organom/3dPrinterV1/Firmware/Marlin + Hysteresis/README.md

# Marlin 3D Printer Firmware


  * [Configuration & Compilation](/Documentation/Compilation.md)
  * Supported
    * [Features](/Documentation/Features.md)
    * [Hardware](/Documentation/Hardware.md)
    * [GCodes](/Documentation/GCodes.md)
  * Notes
    * [Auto Bed Leveling](/Documentation/BedLeveling.md)
    * [Filament Sensor](/Documentation/FilamentSensor.md)
    * [Ramps Servo Power](/Documentation/RampsServoPower.md)

##### [RepRap.org Wiki Page](http://reprap.org/wiki/Marlin)

## Quick Information

This is a firmware for reprap single-processor electronics setups.
It also works on the Ultimaker PCB. It supports printing from SD card+Folders, and look-ahead trajectory planning.
This firmware is a mashup between [Sprinter](https://github.com/kliment/Sprinter), [grbl](https://github.com/simen/grbl) and many original parts.

## Current Status: Bug Fixing

The Marlin development is currently revived. There's a long list of reported issues and pull requests, which we are working on currently.
We are actively looking for testers. So please try the current development version and report new issues and feedback.




What bugs are we working on: [Bug Fixing Round 3](https://github.com/MarlinFirmware/Marlin/milestones/Bug%20Fixing%20Round%203)

## Contact

__IRC:__ #marlin-firmware @freenode ([WebChat Client](https://webchat.freenode.net/?channels=marlin-firmware)

__Mailing List:__ marlin@lists.0l.de ([Subscribe](http://lists.0l.de/mailman/listinfo/marlin), [Archive](http://lists.0l.de/pipermail/marlin/))

## Credits

The current Marlin dev team consists of:

 - Erik van der Zalm ([@ErikZalm](https://github.com/ErikZalm))
 - [@daid](https://github.com/daid)

Sprinters lead developers are Kliment and caru.
Grbls lead developer is Simen Svale Skogsrud.
Sonney Jeon (Chamnit) improved some parts of grbl
A fork by bkubicek for the Ultimaker was merged.

More features have been added by:
  - Lampmaker,
  - Bradley Feldman,
  - and others...

## License

Marlin is published under the [GPL license](/Documentation/COPYING.md) because I believe in open development.
Please do not use this code in products (3D printers, CNC etc) that are closed source or are crippled by a patent.
