organom/3dPrinterV1/Photos/IMG_20151007_074051.jpg

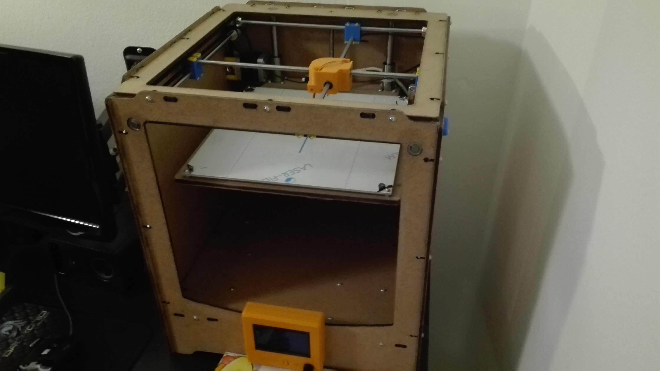
Photos/IMG_20151007_074051.jpg
