organom/3dPrinterV1/Photos/IMG_20160206_153725.jpg

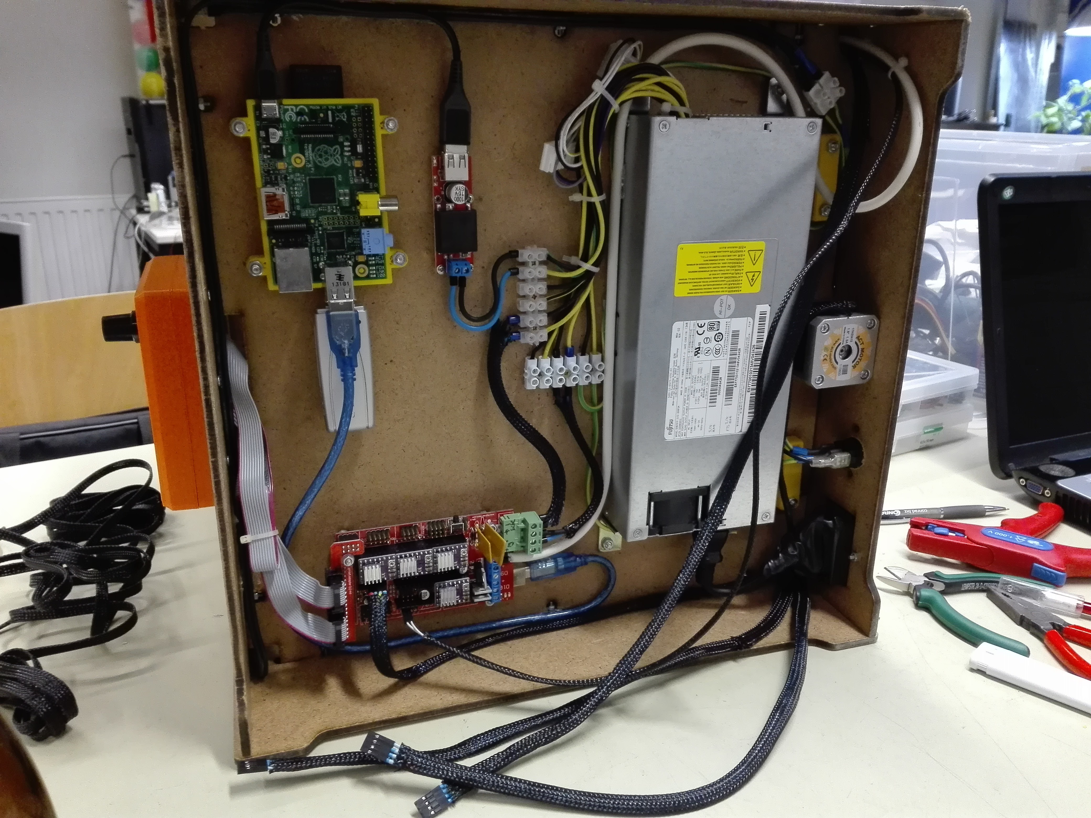
Photos/IMG_20160206_153725.jpg
