organom/3dPrinterV1/Photos/IMG_20160212_201310.jpg

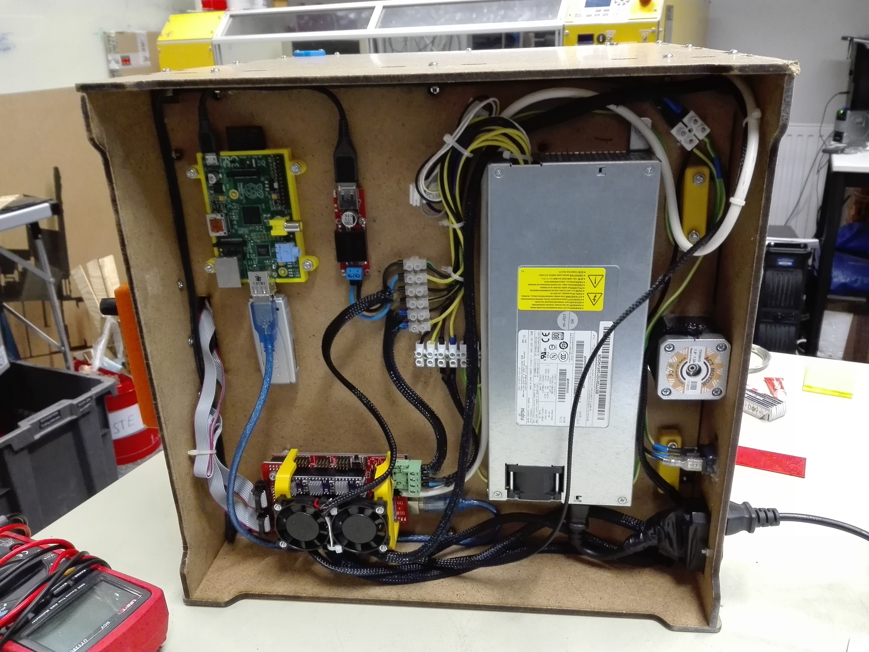
Photos/IMG_20160212_201310.jpg
