organom/3dPrinterV1/Photos/IMG_20160220_092918.jpg

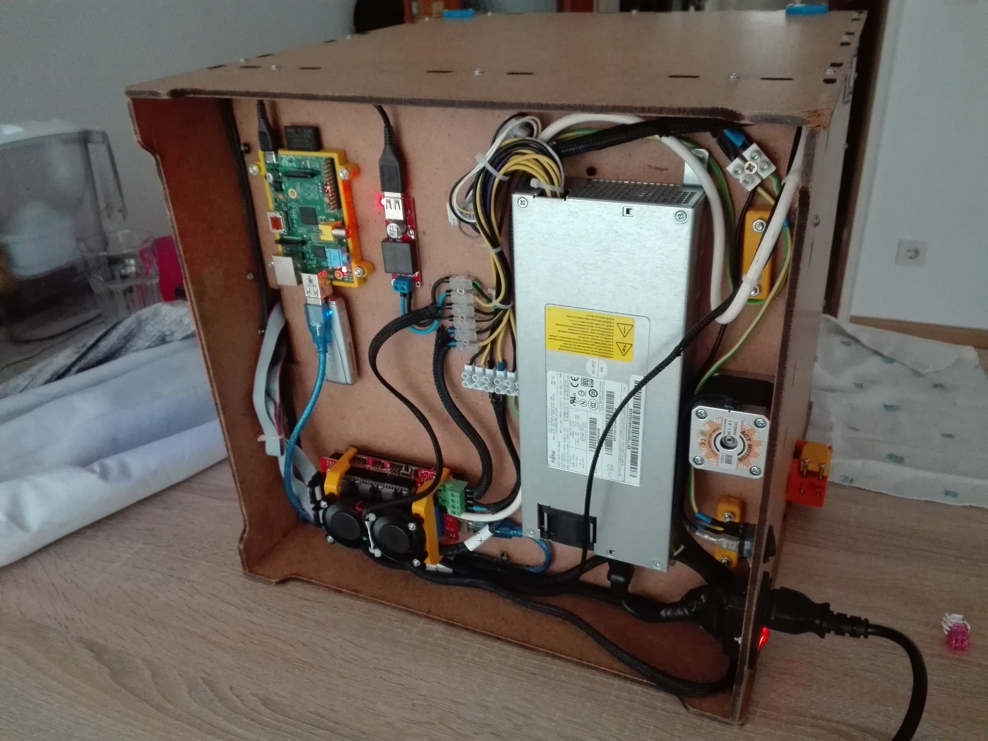
Photos/IMG_20160220_092918.jpg
