organom/3dPrinterV1/Photos/IMG_20170121_103842.jpg

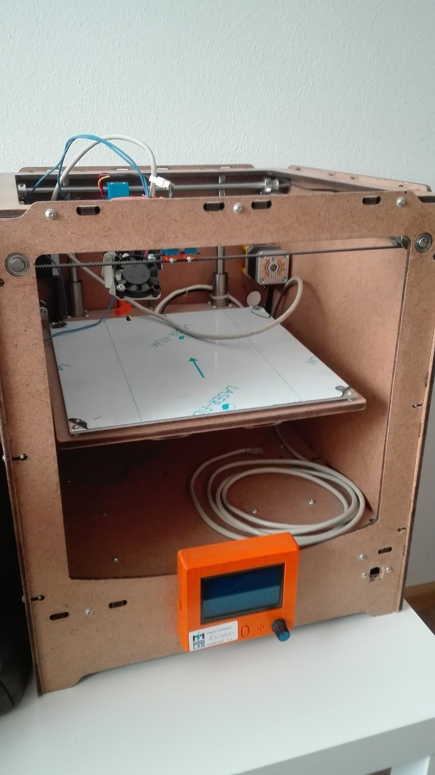
Photos/IMG_20170121_103842.jpg
