organom/3dPrinterV1/Photos/IMG_20170121_103855.jpg

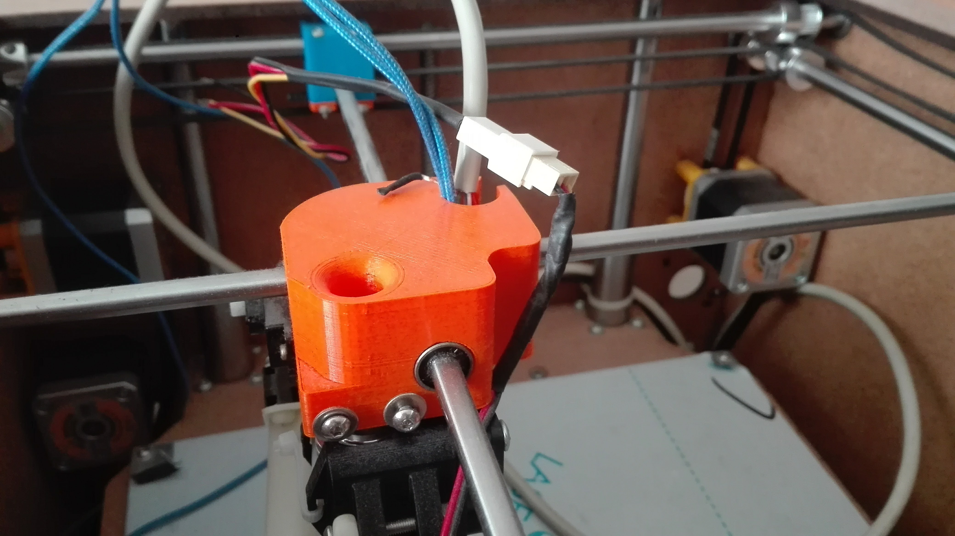
Photos/IMG_20170121_103855.jpg
