organom/3dPrinterV1/Photos/IMG_20170121_103927.jpg

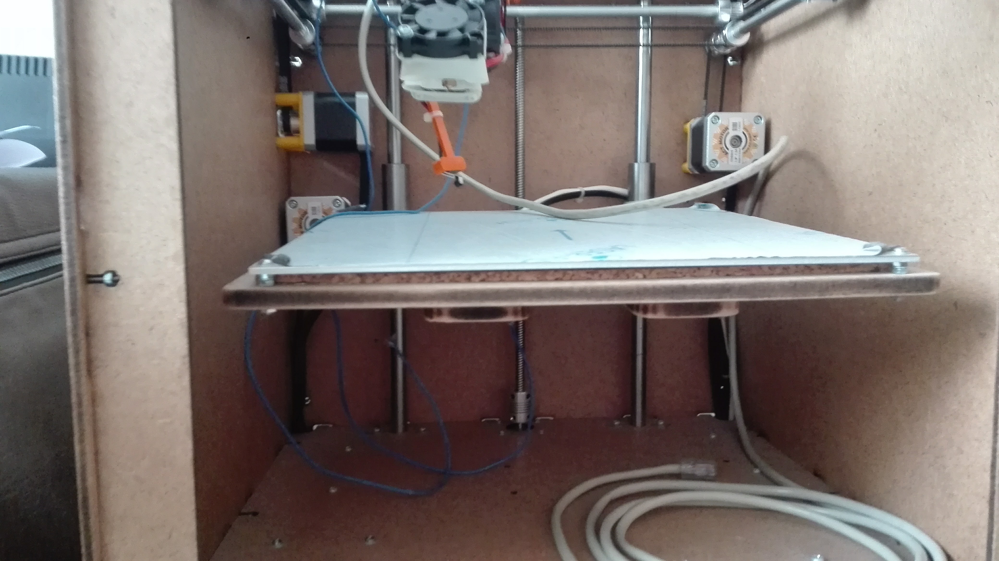
Photos/IMG_20170121_103927.jpg
