organom/3dPrinterV1/Photos/IMG_20170121_103942.jpg

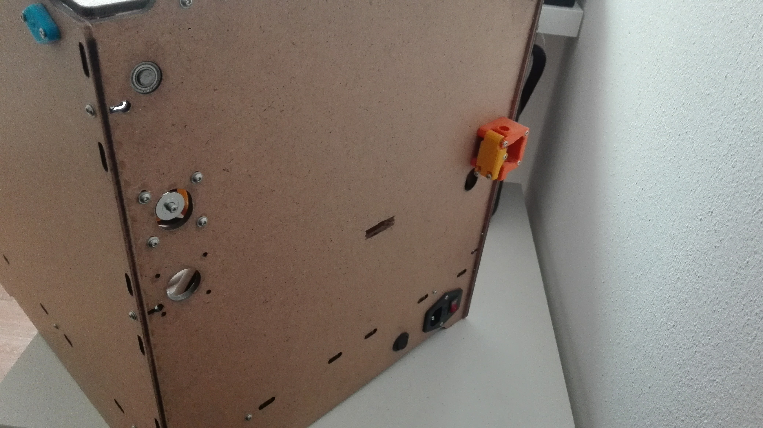
Photos/IMG_20170121_103942.jpg
