organom/3dPrinterV1/Photos/IMG_20170121_104033.jpg

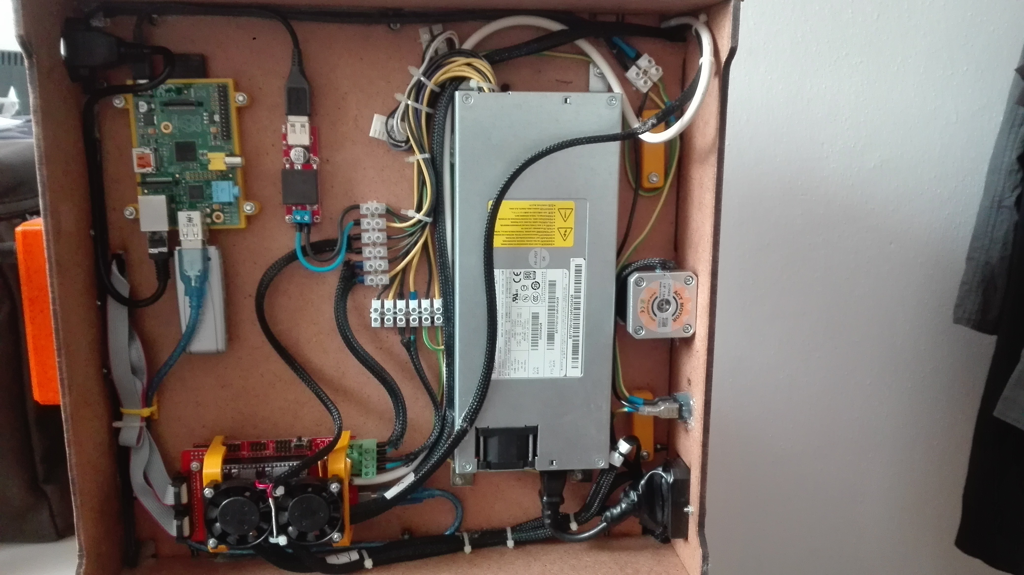
Photos/IMG_20170121_104033.jpg
