organom/3dPrinterV1/Photos/IMG_20170121_104057.jpg

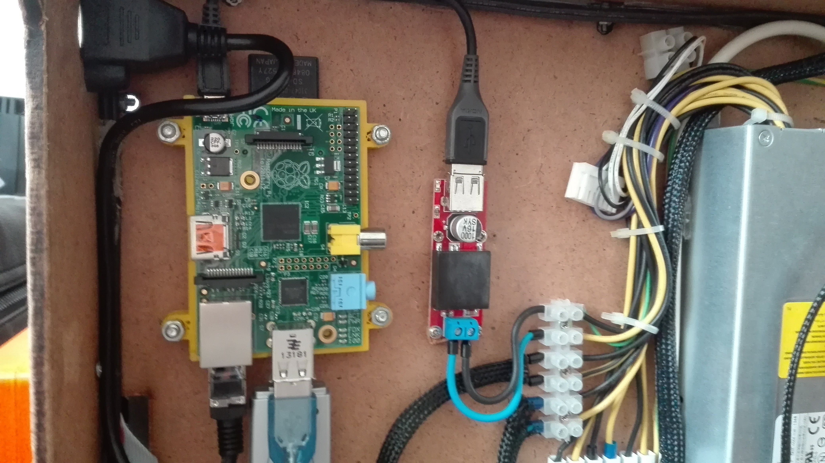
Photos/IMG_20170121_104057.jpg
