organom/3dPrinterV1/Photos/IMG_20170121_105934.jpg

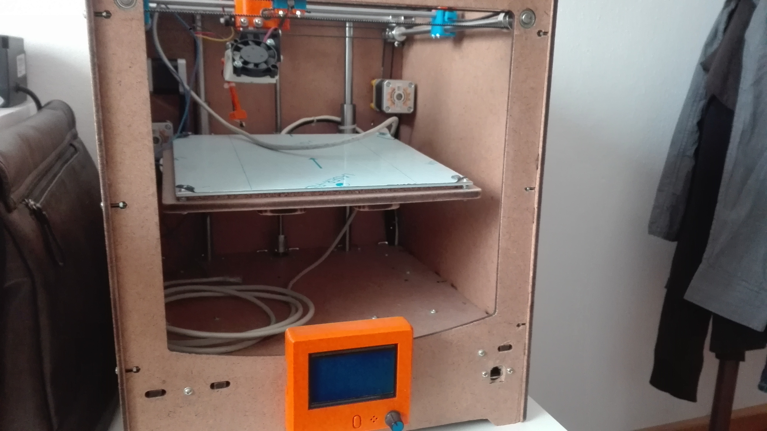
Photos/IMG_20170121_105934.jpg
