organom/3dPrinterV1/3dPrinted parts/E3D V6/SaldoT_E3D_V6_Fanholder_30mm_fans_-_Complete.stl

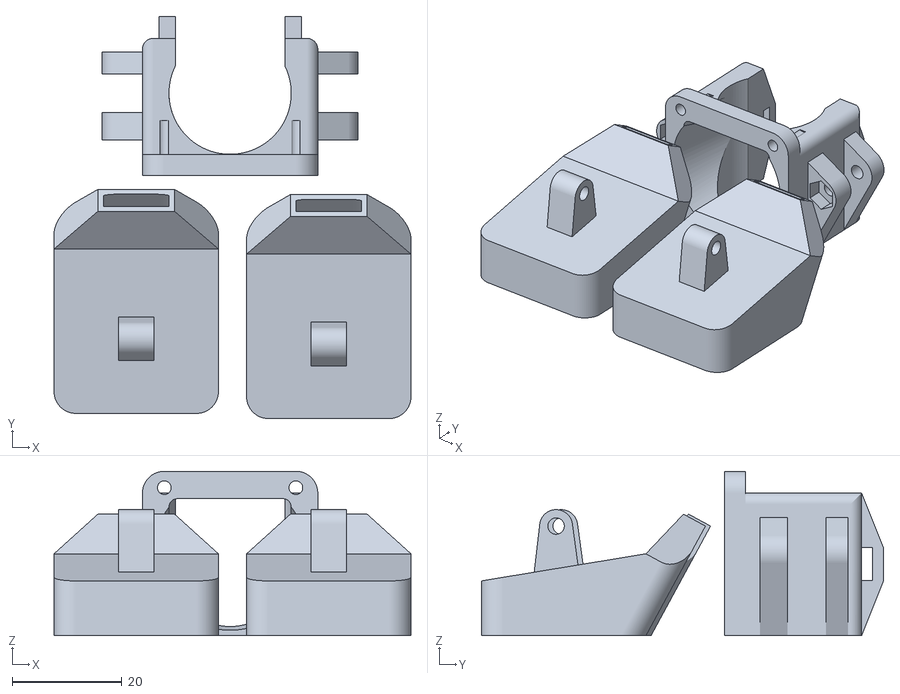
[picture p39: CAD file, 2017-01-24]
3dPrinted parts/E3D V6/SaldoT_E3D_V6_Fanholder_30mm_fans_-_Complete.stl
65.1 x 73.4 x 30.0
