organom/3dPrinterV1/3dPrinted parts/E3D V6/SaldoT_E3D_V6_Fanholder_40mm_fans_-_Complete.stl

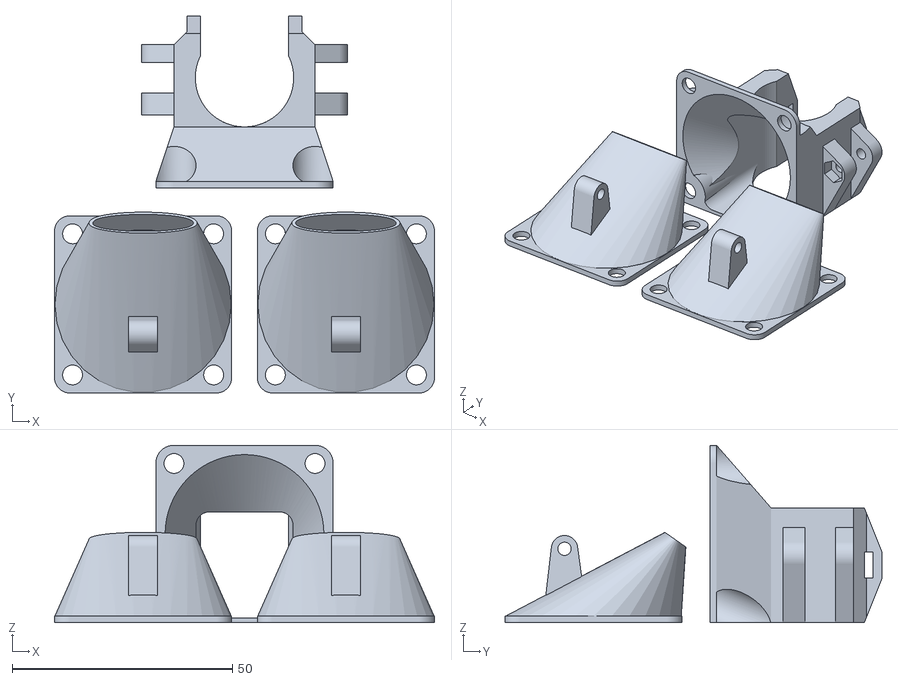
[picture p40: CAD file, 2017-01-24]
3dPrinted parts/E3D V6/SaldoT_E3D_V6_Fanholder_40mm_fans_-_Complete.stl
86.2 x 85.5 x 40.2
