organom/3dPrinterV1/3dPrinted parts/E3D V6/E3D_V6_mount_for_ultimaker_original/E3D_V6_Mount-Main_Body.STL

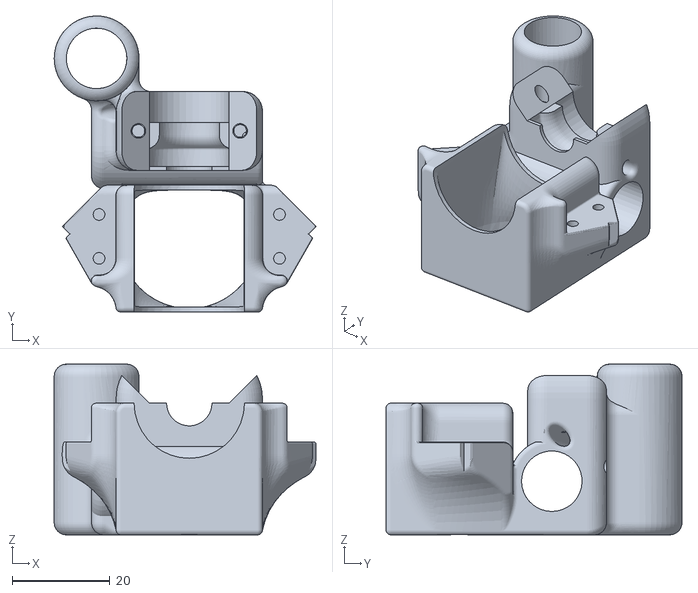
[picture p41: CAD file, 2017-01-24]
3dPrinted parts/E3D V6/E3D_V6_mount_for_ultimaker_original/E3D_V6_Mount-Main_Body.STL
53.6 x 60.7 x 35.0
