organom/3dPrinterV1/3dPrinted parts/E3D V6/E3D_V6_mount_for_ultimaker_original/Right_Fan_.STL

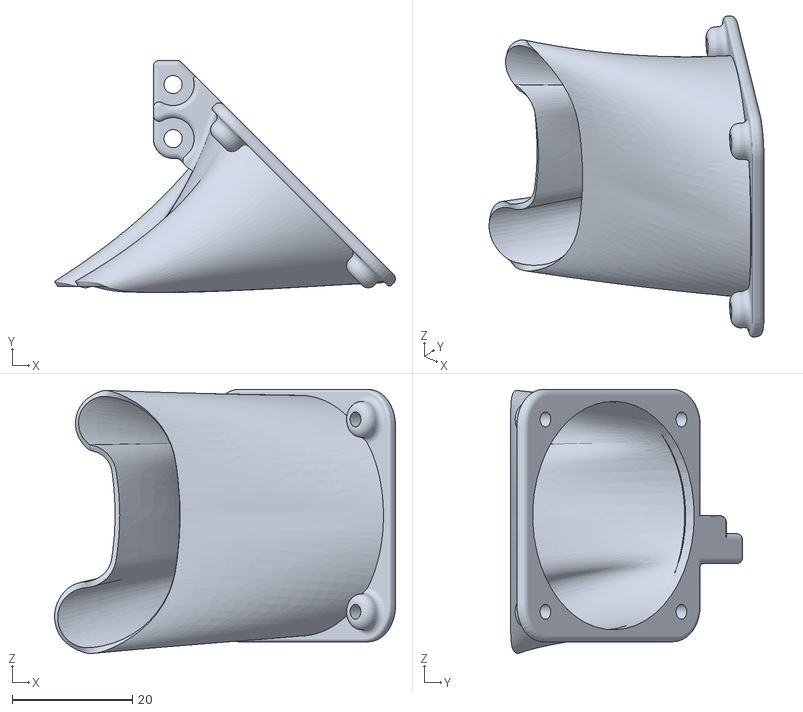
[picture p42: CAD file, 2017-01-24]
3dPrinted parts/E3D V6/E3D_V6_mount_for_ultimaker_original/Right_Fan_.STL
56.7 x 38.6 x 44.0
