organom/3dPrinterV1/3dPrinted parts/Ulticampy v2/015_Tapas Carros laterales - XYSlidingBlockBeltFastener.STL

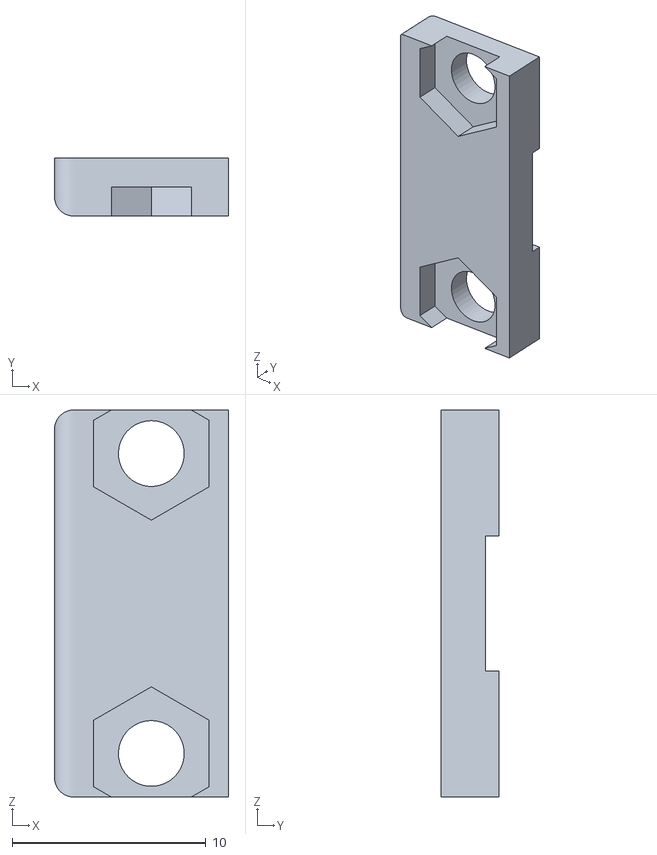
[picture p43: CAD file, 2017-01-24]
3dPrinted parts/Ulticampy v2/015_Tapas Carros laterales - XYSlidingBlockBeltFastener.STL
9.00 x 3.00 x 20.0
