organom/3dPrinterV1/Case parts/dxf-ascii/Panel Izquierdo.dxf

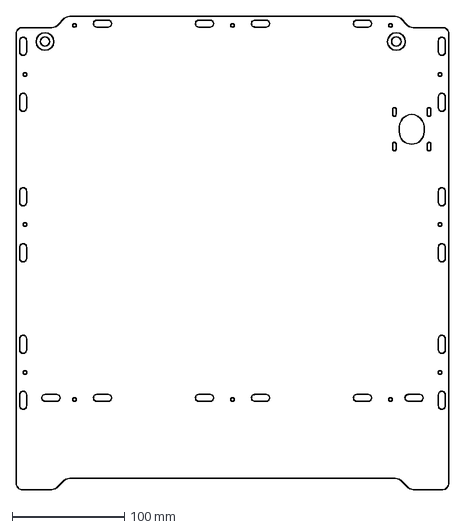
[picture p44: CAD file, 2017-01-24]
Case parts/dxf-ascii/Panel Izquierdo.dxf
386.0 x 422.4 mm
