organom/3dPrinterV1/Case parts/dxf/Base impresion MK2 con refuerzo.dxf

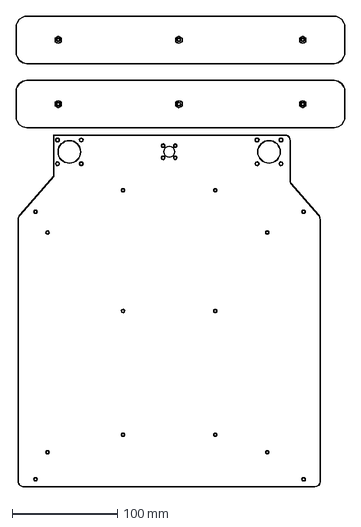
[picture p45: CAD file, 2017-01-24]
Case parts/dxf/Base impresion MK2 con refuerzo.dxf
312.6 x 447.7 mm
