organom/3dPrinterV1/Case parts/STL/Panel Izquierdo.stl

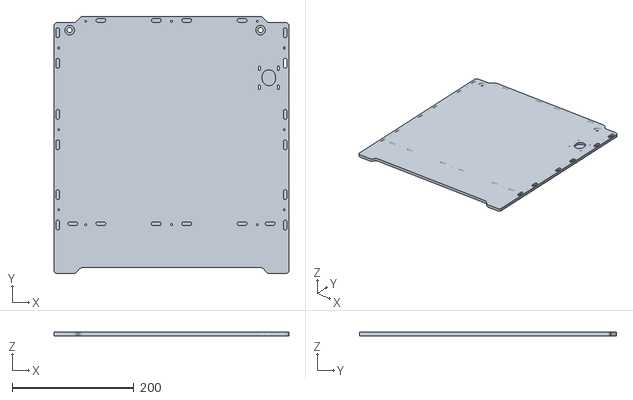
[picture p46: CAD file, 2017-01-24]
Case parts/STL/Panel Izquierdo.stl
386.0 x 422.4 x 6.00
