organom/3dPrinterV1/Firmware/Marlin + Hysteresis/Documentation/Logo/Marlin Logo.dxf

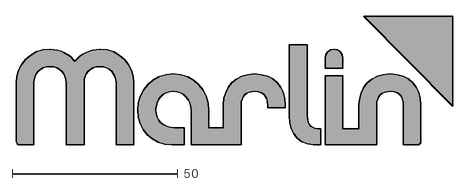
[picture p47: CAD file, 2017-01-24]
Firmware/Marlin + Hysteresis/Documentation/Logo/Marlin Logo.dxf
131.6 x 39.5
