organom/3dPrinterV1/3dPrinted parts/E3D V6/E3D_V6_mount_for_ultimaker_original/E3D_V6_Mount_clamp.STL

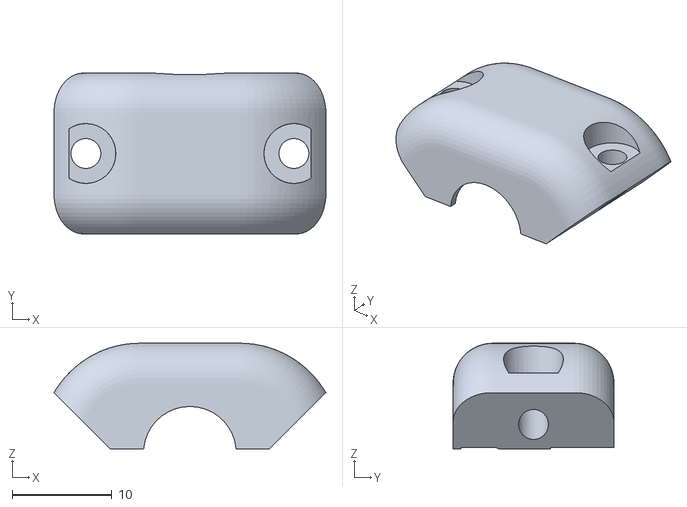
[picture p48: CAD file, 2017-01-24]
3dPrinted parts/E3D V6/E3D_V6_mount_for_ultimaker_original/E3D_V6_Mount_clamp.STL
27.3 x 16.1 x 10.6
