organom/3dPrinterV1/3dPrinted parts/Ulticampy v2/008_RAMPS_Fan_Mount.stl

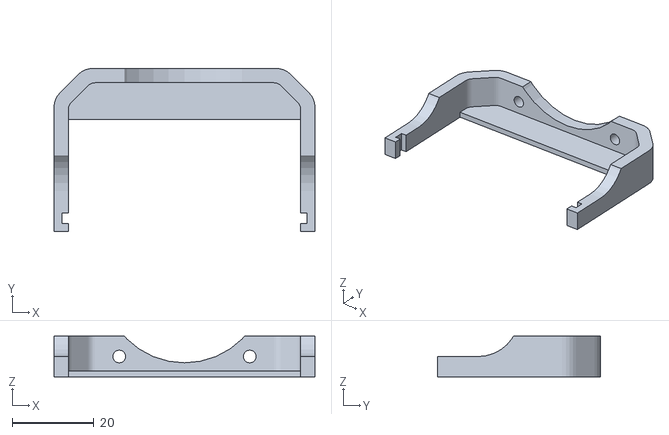
[picture p49: CAD file, 2017-01-24]
3dPrinted parts/Ulticampy v2/008_RAMPS_Fan_Mount.stl
64.0 x 40.0 x 10.0
