organom/3dPrinterV1/Case parts/dxf-ascii/Panel Inferior.dxf

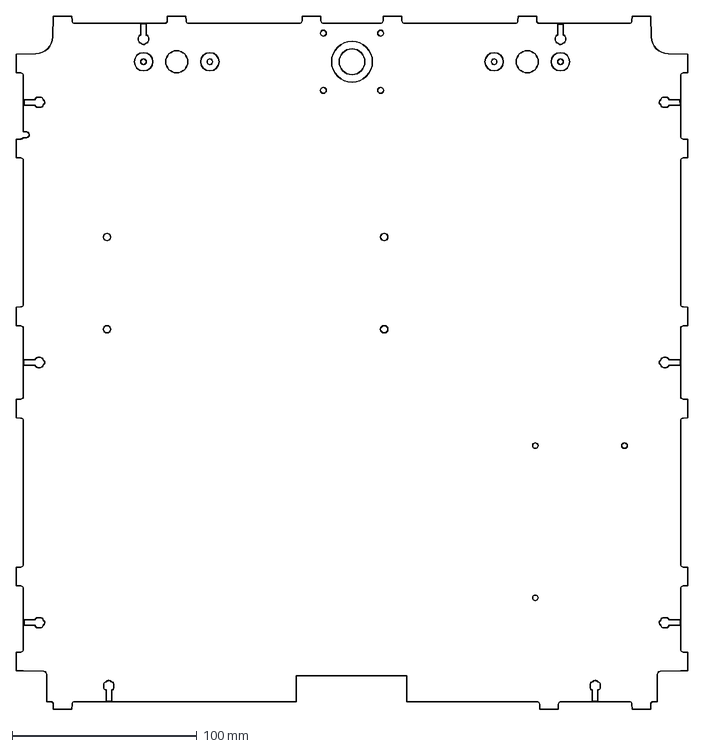
[picture p50: CAD file, 2017-01-24]
Case parts/dxf-ascii/Panel Inferior.dxf
364.2 x 375.6 mm
