organom/3dPrinterV1/Case parts/STL/Panel Trasero.stl

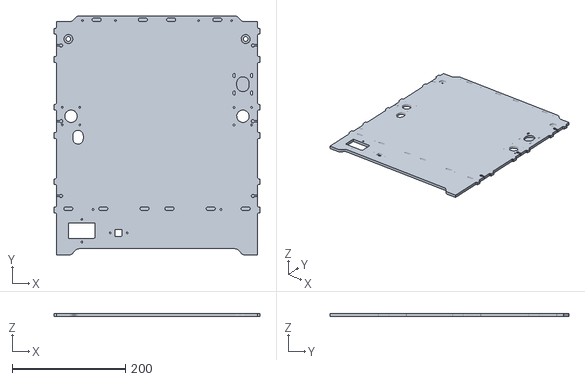
[picture p51: CAD file, 2017-01-24]
Case parts/STL/Panel Trasero.stl
364.2 x 422.2 x 6.00
