organom/3dPrinterV1/3dPrinted parts/E3D V6/E3D_V6_mount_for_ultimaker_original/Left_Fan.STL

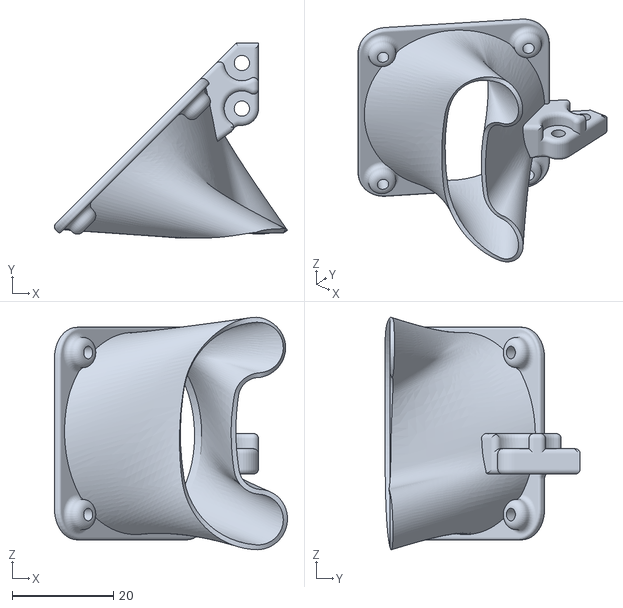
[picture p52: CAD file, 2017-01-24]
3dPrinted parts/E3D V6/E3D_V6_mount_for_ultimaker_original/Left_Fan.STL
46.0 x 38.6 x 45.9
