organom/3dPrinterV1/3dPrinted parts/E3D V6/SaldoT_E3D_V6_Fanholder_40mm_fans_-_Center.stl

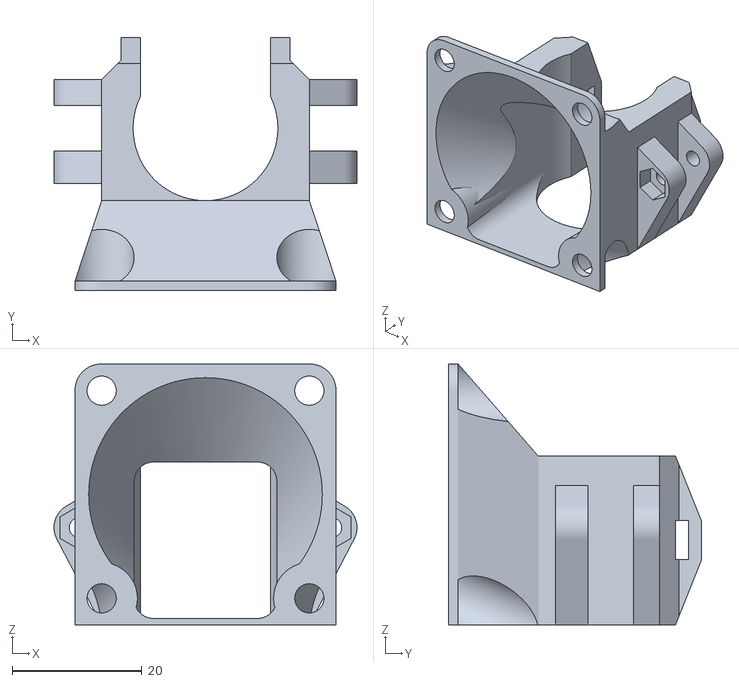
[picture p53: CAD file, 2017-01-24]
3dPrinted parts/E3D V6/SaldoT_E3D_V6_Fanholder_40mm_fans_-_Center.stl
46.7 x 39.0 x 40.2
