organom/3dPrinterV1/3dPrinted parts/Ulticampy v2/012_soporteendstopz_(repaired).stl

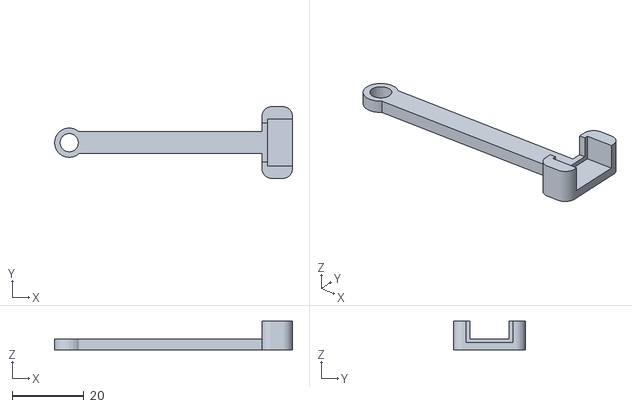
[picture p54: CAD file, 2017-01-24]
3dPrinted parts/Ulticampy v2/012_soporteendstopz_(repaired).stl
66.4 x 20.0 x 8.00
