organom/3dPrinterV1/Case parts/dxf-ascii/Panel Trasero.dxf

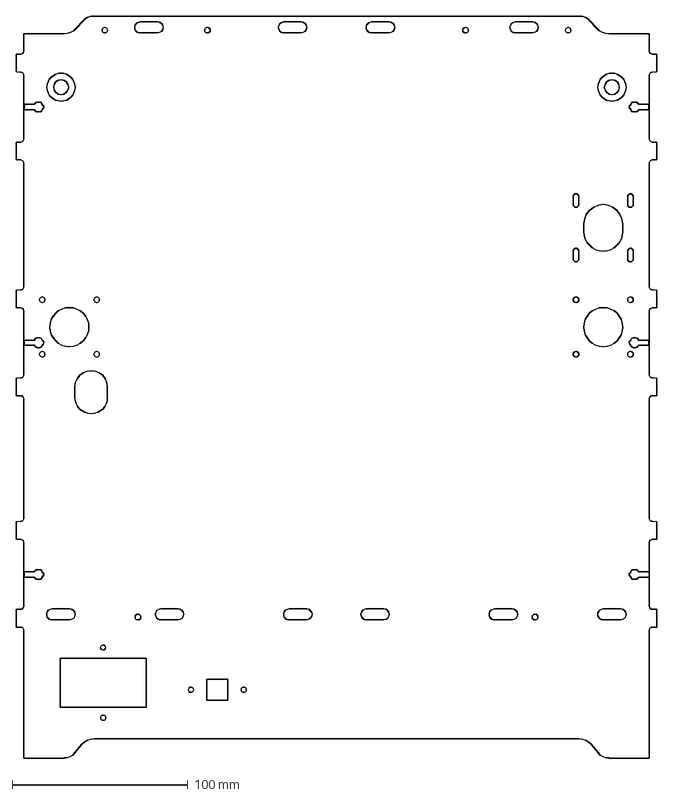
[picture p55: CAD file, 2017-01-24]
Case parts/dxf-ascii/Panel Trasero.dxf
364.2 x 422.2 mm
