organom/3dPrinterV1/Case parts/STL/Panel Frontal.stl

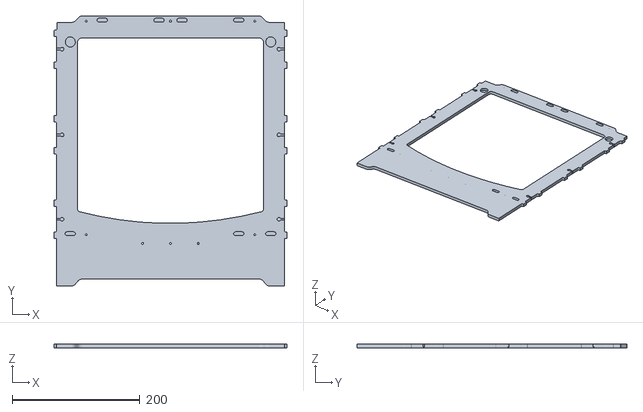
[picture p56: CAD file, 2017-01-24]
Case parts/STL/Panel Frontal.stl
364.2 x 422.2 x 6.00
