organom/3dPrinterV1/3dPrinted parts/E3D V6/SaldoT_E3D_V6_Fanholder_5015_fan.stl

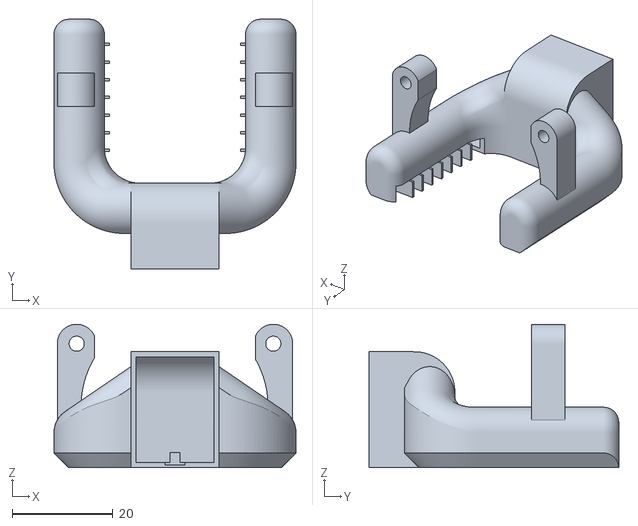
[picture p57: CAD file, 2017-01-24]
3dPrinted parts/E3D V6/SaldoT_E3D_V6_Fanholder_5015_fan.stl
48.0 x 49.5 x 28.4
