organom/3dPrinterV1/3dPrinted parts/Ulticampy v2/010_soporteendstopX.stl

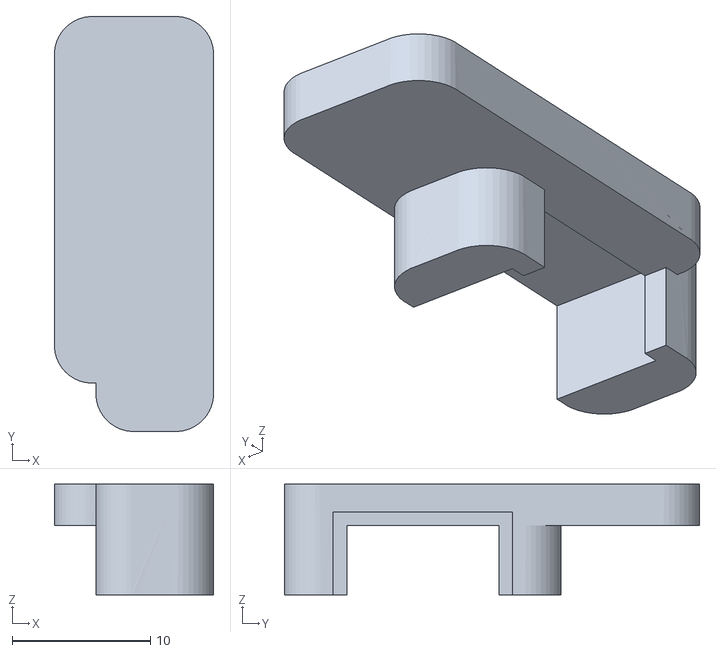
[picture p58: CAD file, 2017-01-24]
3dPrinted parts/Ulticampy v2/010_soporteendstopX.stl
11.5 x 30.0 x 8.00
