organom/3dPrinterV1/Case parts/dxf-ascii/Panel Derecho.dxf

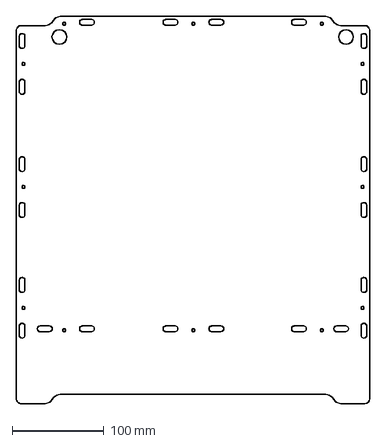
[picture p59: CAD file, 2017-01-24]
Case parts/dxf-ascii/Panel Derecho.dxf
385.0 x 422.1 mm
