organom/3dPrinterV1/Case parts/STL/Refuerzo Base de impresion.stl

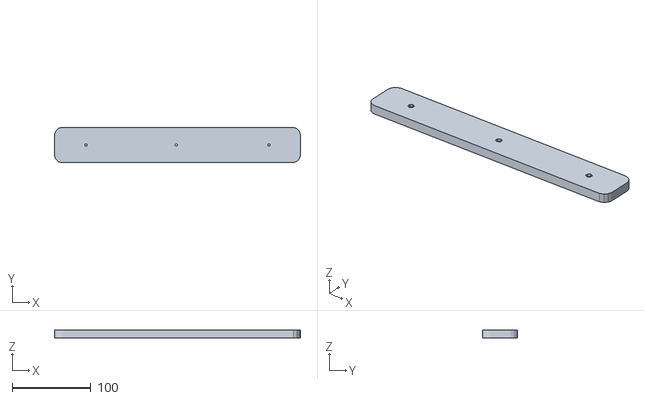
[picture p60: CAD file, 2017-01-24]
Case parts/STL/Refuerzo Base de impresion.stl
312.6 x 45.0 x 10.0
