organom/3dPrinterV1/3dPrinted parts/E3D V6/E3D_V6__cooling_fan_mount_with_blower_attachment.stl

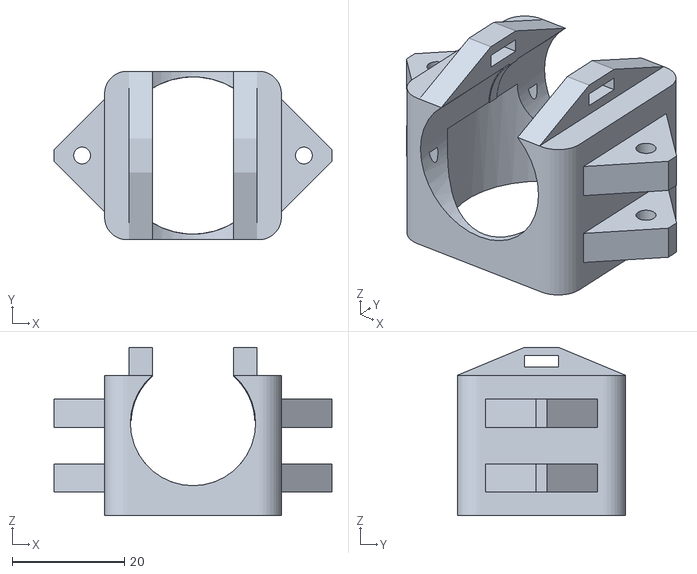
[picture p61: CAD file, 2017-01-24]
3dPrinted parts/E3D V6/E3D_V6__cooling_fan_mount_with_blower_attachment.stl
49.5 x 30.0 x 30.0
