organom/3dPrinterV1/3dPrinted parts/Ulticampy v2/013_soportemotor_(repaired).STL

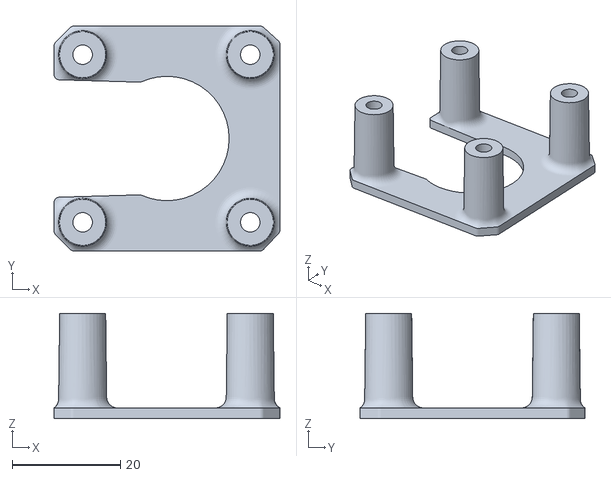
[picture p62: CAD file, 2017-01-24]
3dPrinted parts/Ulticampy v2/013_soportemotor_(repaired).STL
41.8 x 41.6 x 19.5
