organom/3dPrinterV1/Case parts/dxf-ascii/Panel Frontal.dxf

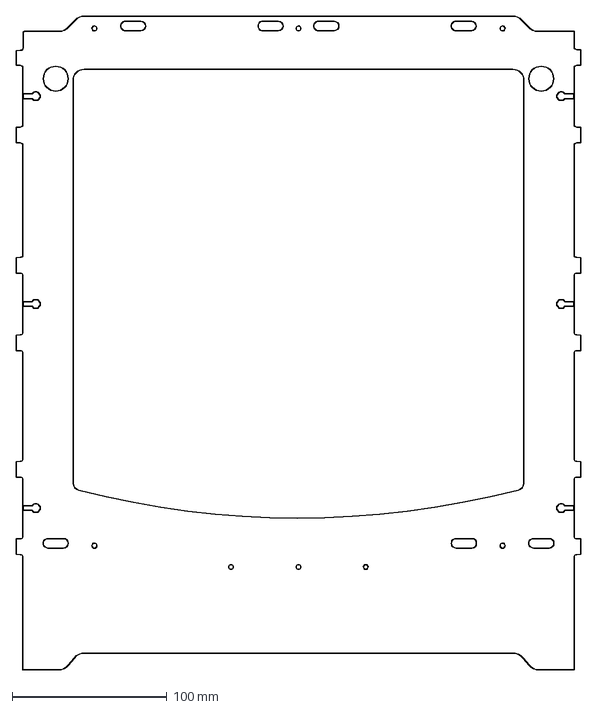
[picture p63: CAD file, 2017-01-24]
Case parts/dxf-ascii/Panel Frontal.dxf
364.2 x 422.3 mm
