organom/3dPrinterV1/Case parts/STL/Panel Superior.stl

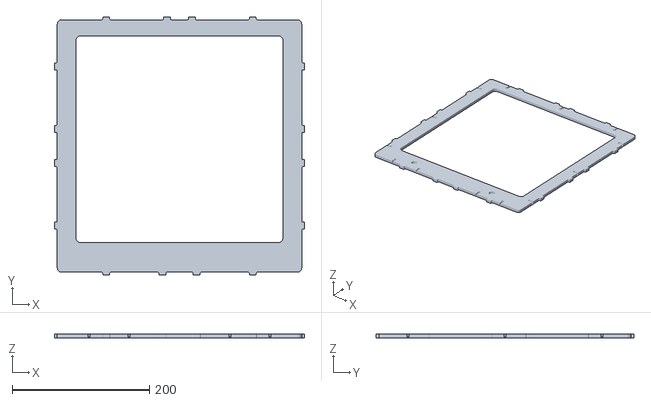
[picture p64: CAD file, 2017-01-24]
Case parts/STL/Panel Superior.stl
364.2 x 375.6 x 6.00
