organom/3dPrinterV1/3dPrinted parts/E3D V6/SaldoT_E3D_V6_Fanholder_40mm_fans_-_Side.stl

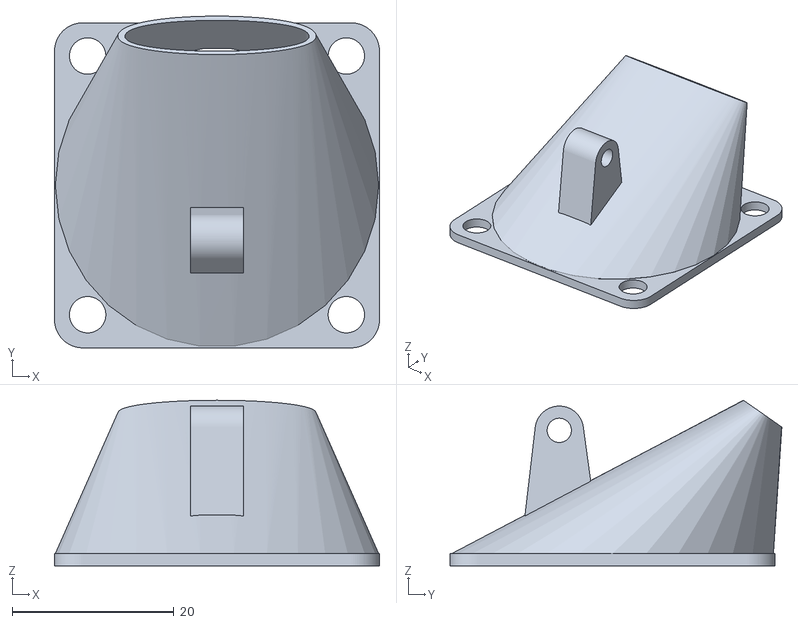
[picture p65: CAD file, 2017-01-24]
3dPrinted parts/E3D V6/SaldoT_E3D_V6_Fanholder_40mm_fans_-_Side.stl
40.2 x 41.0 x 20.5
