organom/3dPrinterV1/3dPrinted parts/Ulticampy v2/016_ventiladorcapa_(repaired).stl

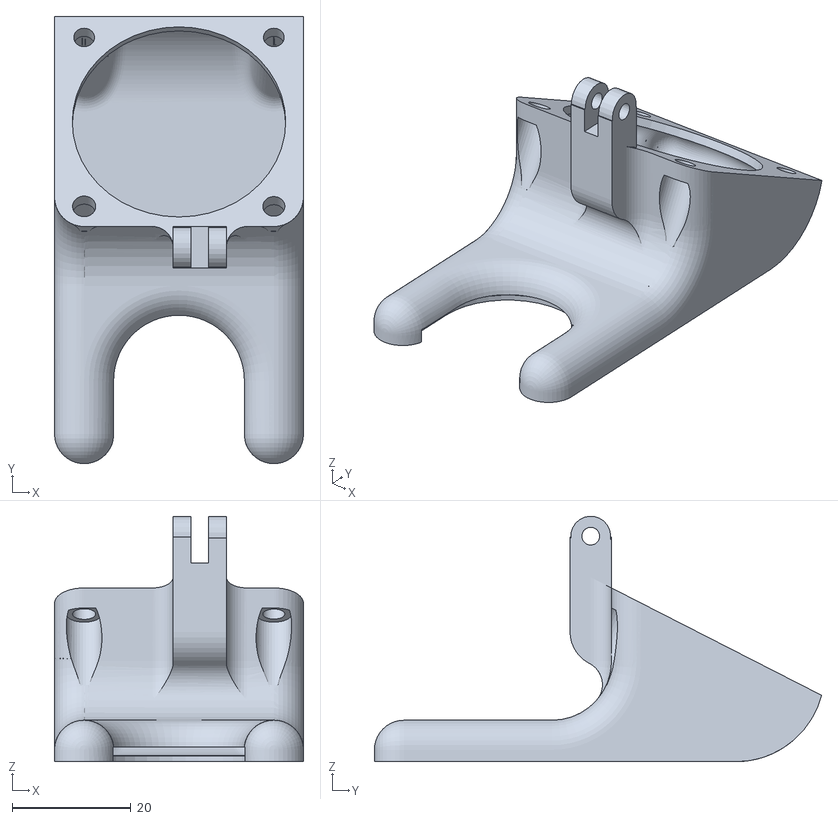
[picture p66: CAD file, 2017-01-24]
3dPrinted parts/Ulticampy v2/016_ventiladorcapa_(repaired).stl
42.0 x 75.5 x 41.4
