organom/3dPrinterV1/Case parts/STL/Base de impresion.stl

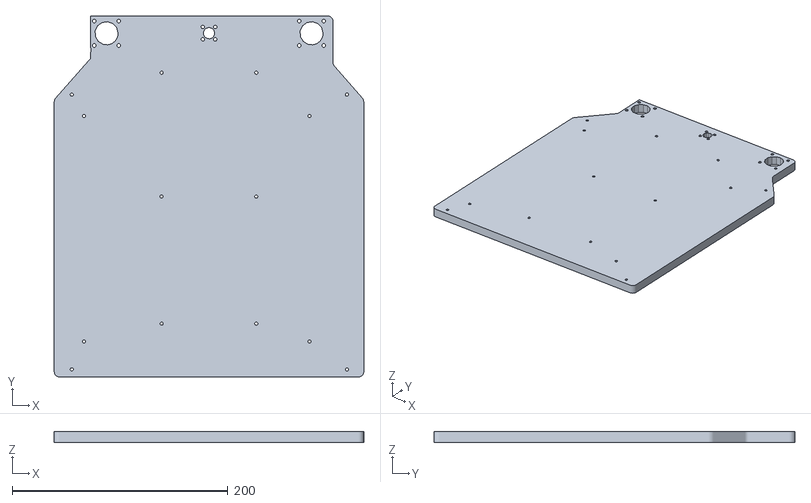
[picture p68: CAD file, 2017-01-24]
Case parts/STL/Base de impresion.stl
287.0 x 334.6 x 10.0
