organom/3dPrinterV1/3dPrinted parts/E3D V6/SaldoT_E3D_V6_Fanholder_30mm_fans_-_Center.stl

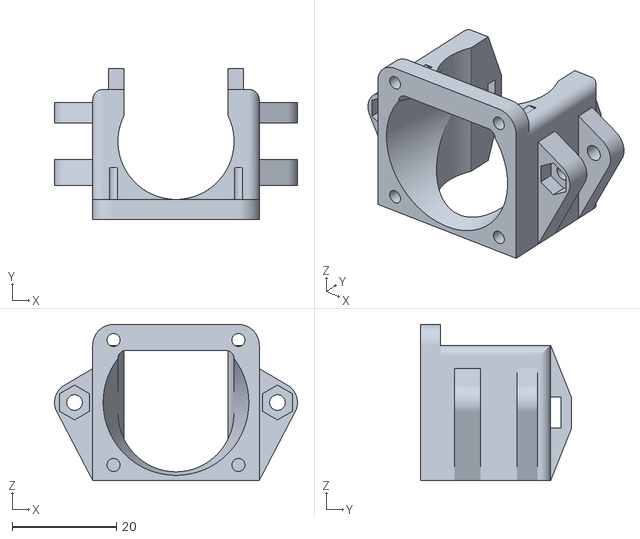
[picture p69: CAD file, 2017-01-24]
3dPrinted parts/E3D V6/SaldoT_E3D_V6_Fanholder_30mm_fans_-_Center.stl
46.7 x 29.0 x 30.0
