organom/3dPrinterV1/3dPrinted parts/Ulticampy v2/002 LCD - carcasalcddel.stl

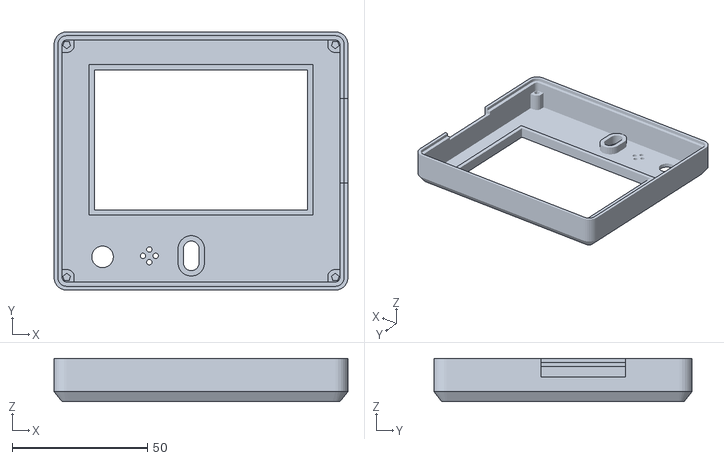
[picture p70: CAD file, 2017-01-24]
3dPrinted parts/Ulticampy v2/002 LCD - carcasalcddel.stl
108.6 x 95.4 x 16.0
