organom/3dPrinterV1/Case parts/dxf-ascii/Panel Superior.dxf

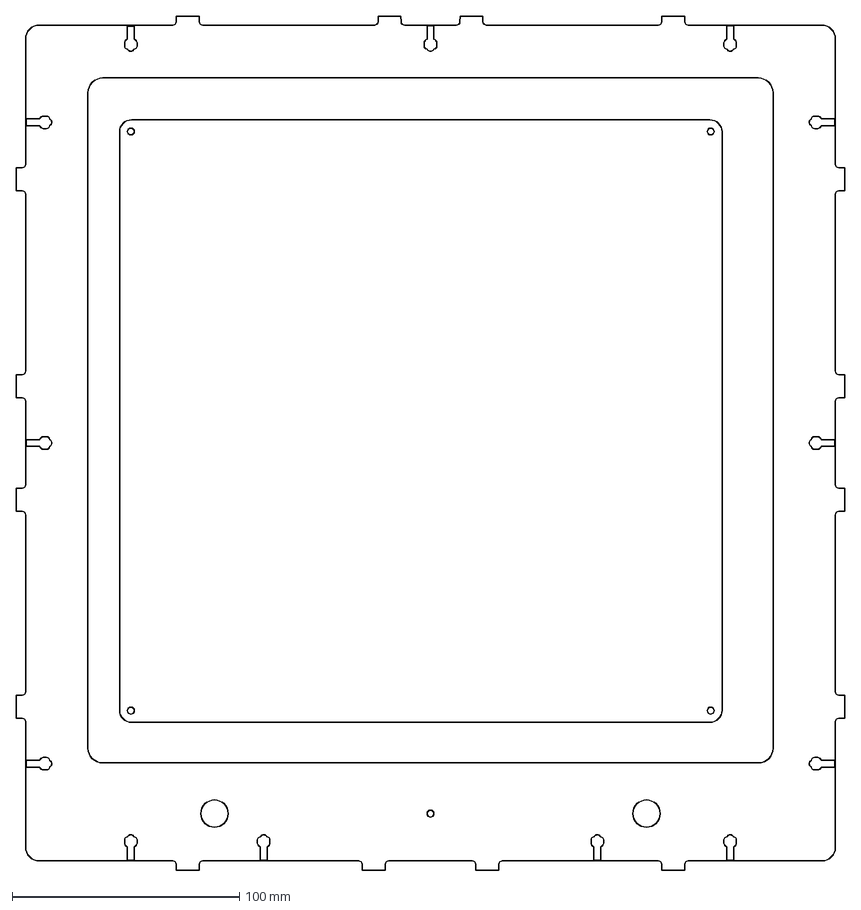
[picture p71: CAD file, 2017-01-24]
Case parts/dxf-ascii/Panel Superior.dxf
364.2 x 375.6 mm
