organom/3dPrinterV1/Case parts/STL/Panel Derecho.stl

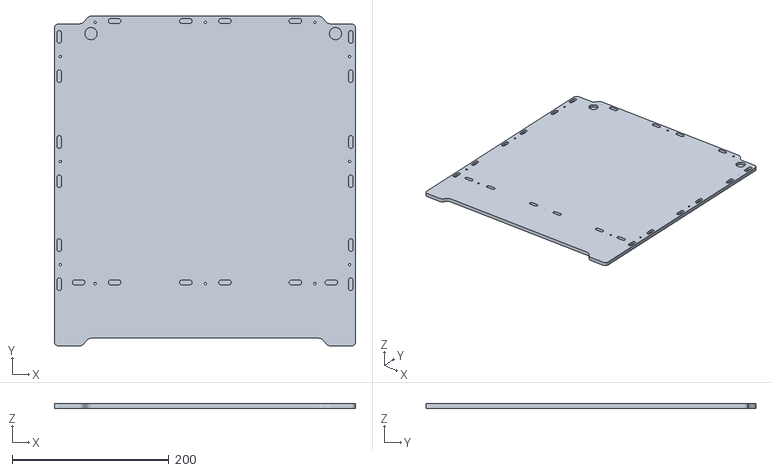
[picture p72: CAD file, 2017-01-24]
Case parts/STL/Panel Derecho.stl
385.0 x 421.7 x 6.00
