organom/3dPrinterV1/3dPrinted parts/E3D V6/SaldoT_E3D_V6_Fanholder_30mm_fans_-_Side.stl

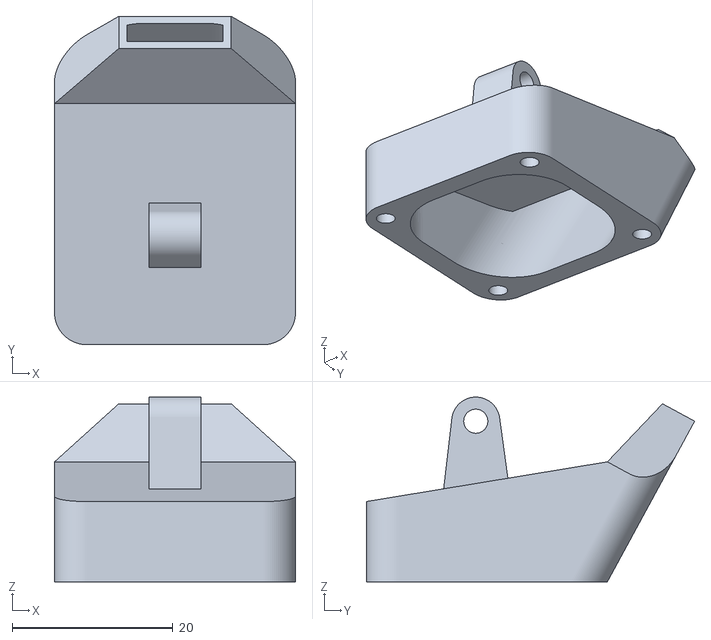
[picture p73: CAD file, 2017-01-24]
3dPrinted parts/E3D V6/SaldoT_E3D_V6_Fanholder_30mm_fans_-_Side.stl
30.0 x 40.9 x 23.0
