organom/3dPrinterV1/3dPrinted parts/Ulticampy v2/005_Carros laterales - XYSlidingBlock_v2.STL

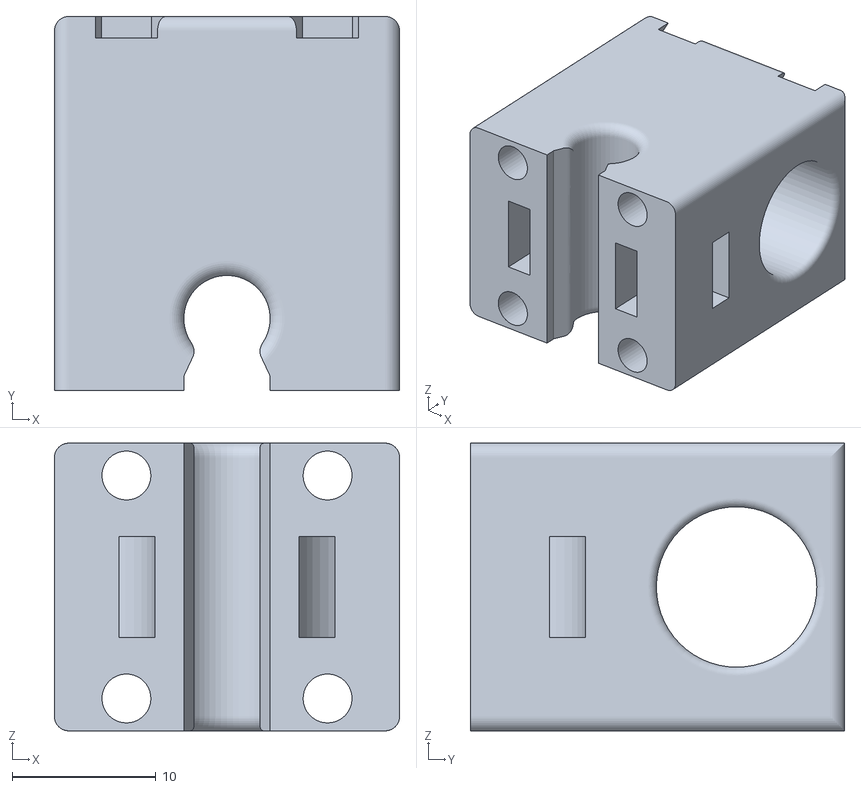
[picture p74: CAD file, 2017-01-24]
3dPrinted parts/Ulticampy v2/005_Carros laterales - XYSlidingBlock_v2.STL
24.0 x 26.0 x 20.0
