organom/3dPrinterV1/Case parts/STL/Bandeja impresion.stl

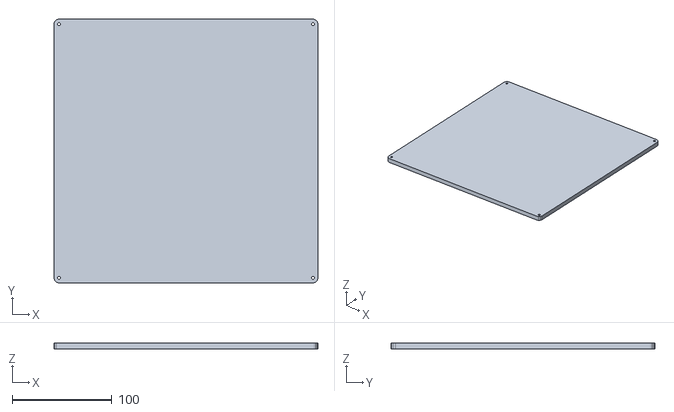
[picture p75: CAD file, 2017-01-24]
Case parts/STL/Bandeja impresion.stl
265.0 x 265.0 x 6.00
