organom/3dPrinterV1/3dPrinted parts/Ulticampy v2/011_soporteendstopY.stl

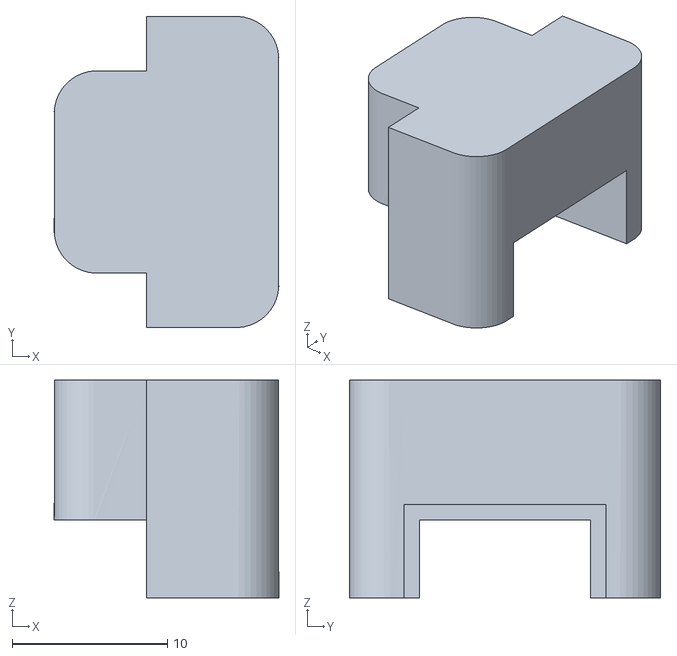
[picture p76: CAD file, 2017-01-24]
3dPrinted parts/Ulticampy v2/011_soporteendstopY.stl
14.5 x 20.0 x 14.0
