organom/3dPrinterV1/Case parts/STL/Panel Inferior.stl

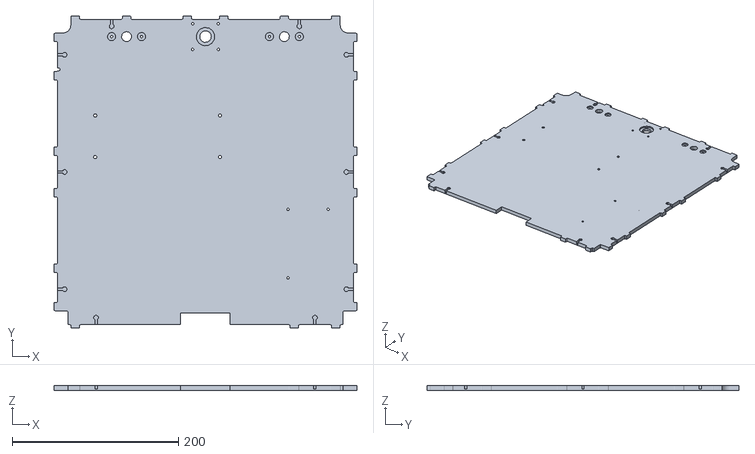
[picture p77: CAD file, 2017-01-24]
Case parts/STL/Panel Inferior.stl
364.2 x 375.6 x 6.00
