organom/3dPrinterV1/3dPrinted parts/Ulticampy v2/014_soporteVarillas_Z.STL

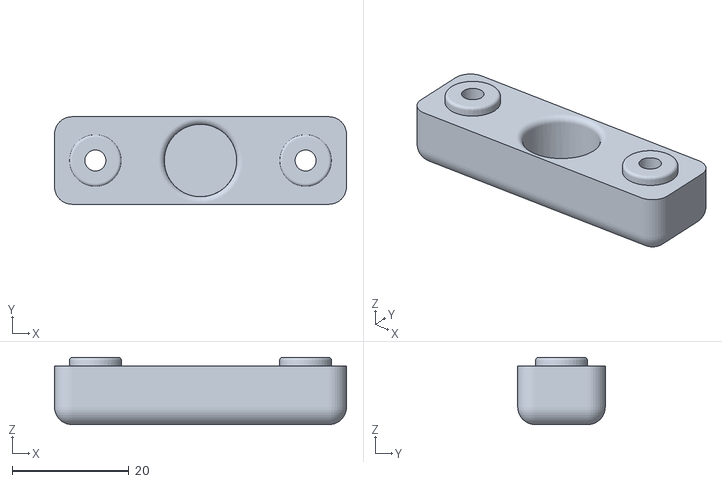
[picture p78: CAD file, 2017-01-24]
3dPrinted parts/Ulticampy v2/014_soporteVarillas_Z.STL
50.0 x 15.0 x 11.5
