organom/3dPrinterV1/3dPrinted parts/Ulticampy v2/006_idlermk4.png.stl

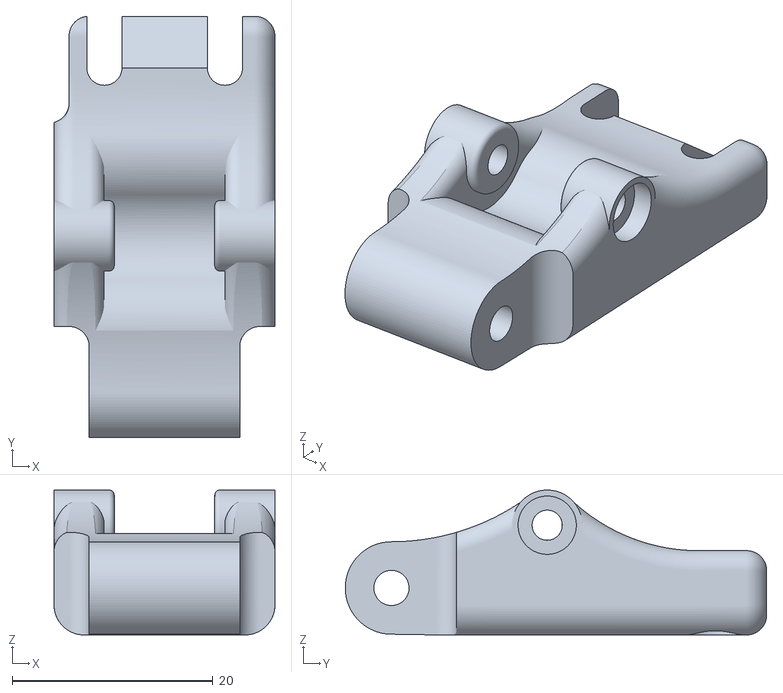
[picture p79: CAD file, 2017-01-24]
3dPrinted parts/Ulticampy v2/006_idlermk4.png.stl
22.0 x 42.0 x 14.4
