organom/3dPrinterV1/3dPrinted parts/Ulticampy v2/001 LCD - botonkill.stl

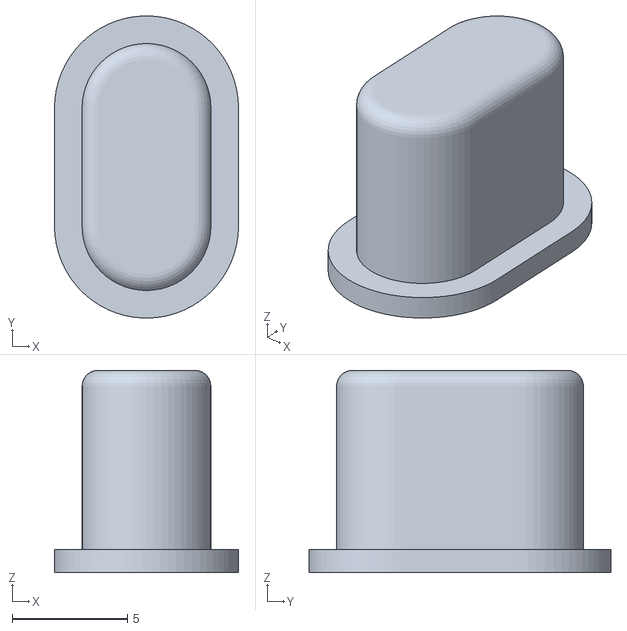
[picture p80: CAD file, 2017-01-24]
3dPrinted parts/Ulticampy v2/001 LCD - botonkill.stl
8.00 x 13.1 x 8.80
