organom/3dPrinterV1/3dPrinted parts/Ulticampy v2/004 Carro central para E3DV6.STL

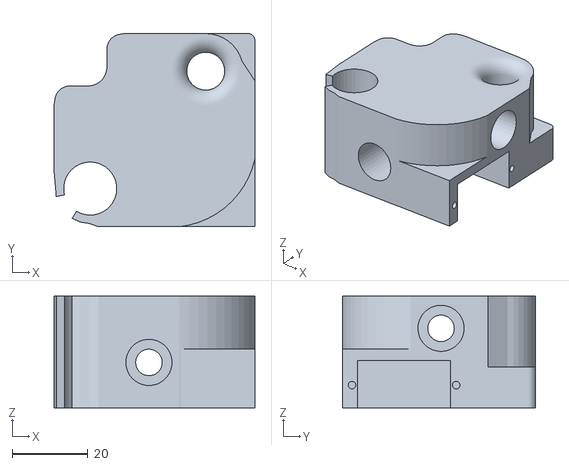
[picture p81: CAD file, 2017-01-24]
3dPrinted parts/Ulticampy v2/004 Carro central para E3DV6.STL
53.1 x 51.1 x 29.5
