organom/3dPrinterV1/3dPrinted parts/Ulticampy v2/007_Infill_3D_Bowden_Extruder_Direct_Mount_13.5_MK3.STL

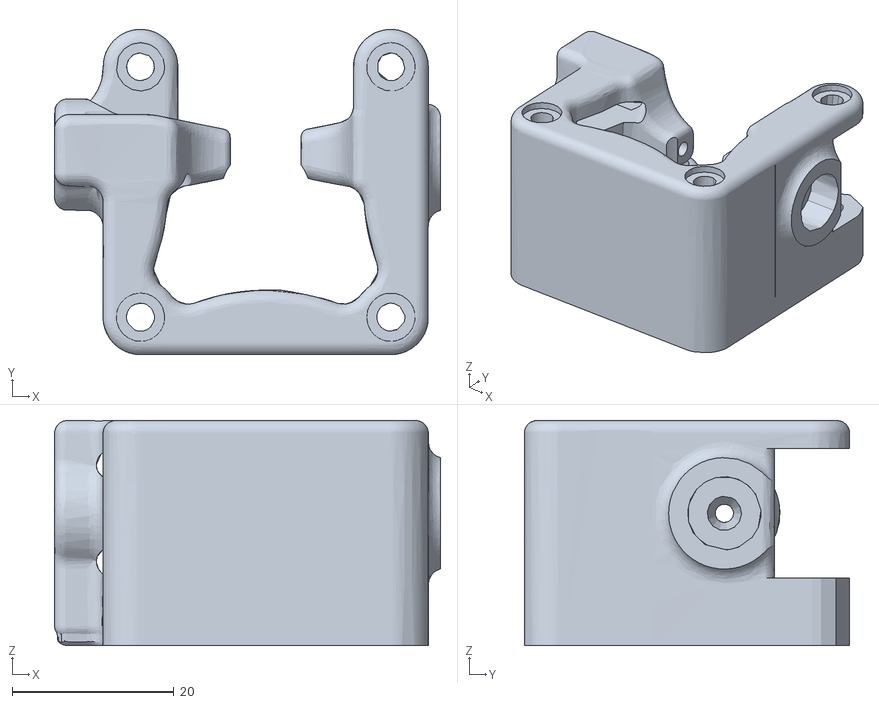
[picture p82: CAD file, 2017-01-24]
3dPrinted parts/Ulticampy v2/007_Infill_3D_Bowden_Extruder_Direct_Mount_13.5_MK3.STL
47.8 x 40.3 x 27.9
