organom/3dPrinterV1/3dPrinted parts/Ulticampy v2/003 LCD - carcasalcdtras.stl

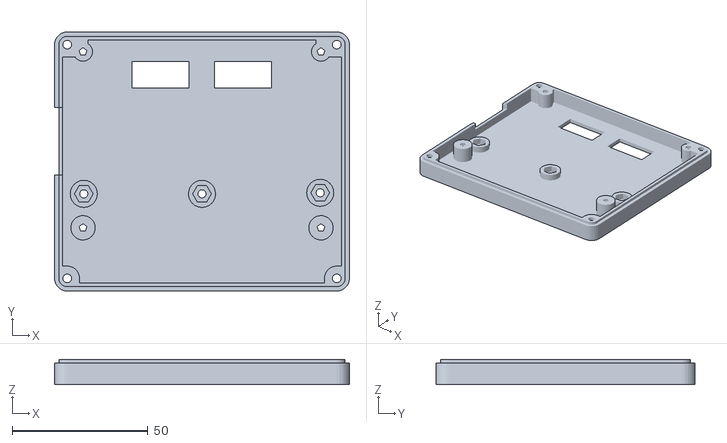
[picture p83: CAD file, 2017-01-24]
3dPrinted parts/Ulticampy v2/003 LCD - carcasalcdtras.stl
108.6 x 95.4 x 9.28
