organom/3dPrinterV1/3dPrinted parts/Ulticampy v2/009_soportecables.stl

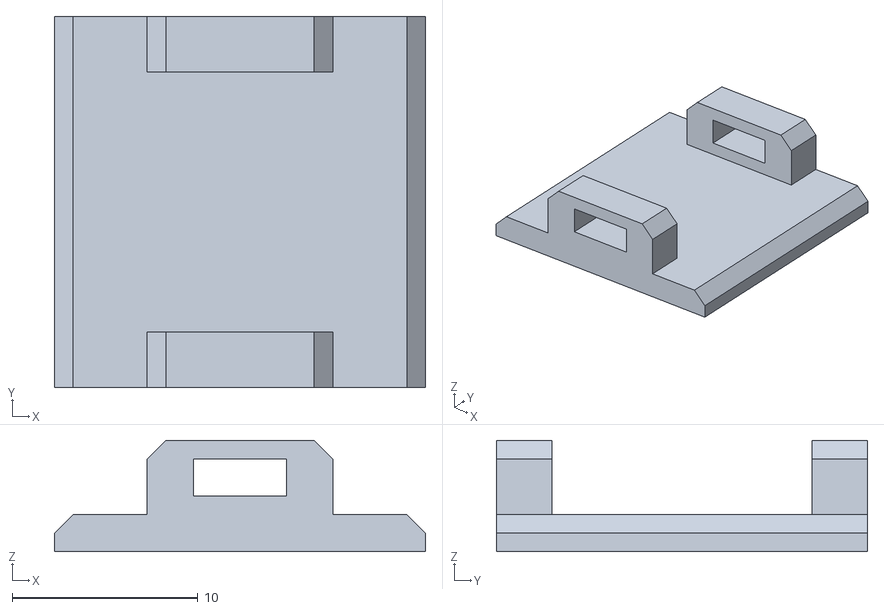
[picture p84: CAD file, 2017-01-24]
3dPrinted parts/Ulticampy v2/009_soportecables.stl
20.0 x 20.0 x 6.00
