organom/3dPrinterV1/(list of files, cad)

Other CAD files:
Case parts/DWG/Base impresion MK2 con refuerzo.dwg
Case parts/DWG/Panel Derecho.dwg
Case parts/DWG/Panel Frontal.dwg
Case parts/DWG/Panel Inferior.dwg
Case parts/DWG/Panel Izquierdo.dwg
Case parts/DWG/Panel Superior.dwg
Case parts/DWG/Panel Trasero.dwg
Case parts/dxf/Panel Derecho.dxf
Case parts/dxf/Panel Frontal.dxf
Case parts/dxf/Panel Inferior.dxf
Case parts/dxf/Panel Izquierdo.dxf
Case parts/dxf/Panel Superior.dxf
Case parts/dxf/Panel Trasero.dxf
