organom/3dPrinterV1/(commit log)

2017-01-24 Merged my ulticampy v2 version with the files already present. General cleanup
    [001 LCD - botonkill.stl, 002 LCD - carcasalcddel.stl, 003 LCD - carcasalcdtras.stl, 004 Carro central para E3DV6.STL, 005_Carros laterales - XYSlidingBlock_v2.STL, 006_idlermk4.png.stl, 007_Infill_3D_Bowden_Extruder_Direct_Mount_13.5_MK3.STL, 008_RAMPS_Fan_Mount.stl]
2017-01-24 Fixed typo. Added brief introduction.
    [Configuration.h, Configuration_adv.h, Marlin Logo.dxf, Menu Plans.xlsx]
